suya100046834/a5d27_handheld_console/a5d27_handheld_console_pcb/3d/ER-TFTM043A2-3-4170_3D.STEP

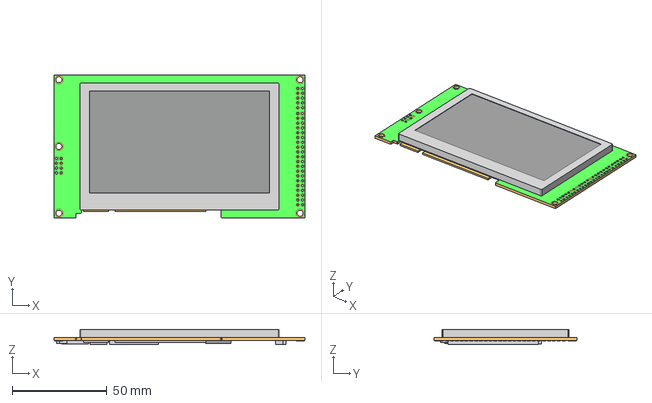
[picture p1: CAD file, 2024-01-07]
a5d27_handheld_console_pcb/3d/ER-TFTM043A2-3-4170_3D.STEP
132.7 x 75.8 x 7.90 mm
