suya100046834/a5d27_handheld_console/a5d27_handheld_console_pcb/a5d27_handheld_console_pcb.kicad_pcb

## KiCad design a5d27_handheld_console_pcb/a5d27_handheld_console_pcb.kicad_pcb (2024-01-07)

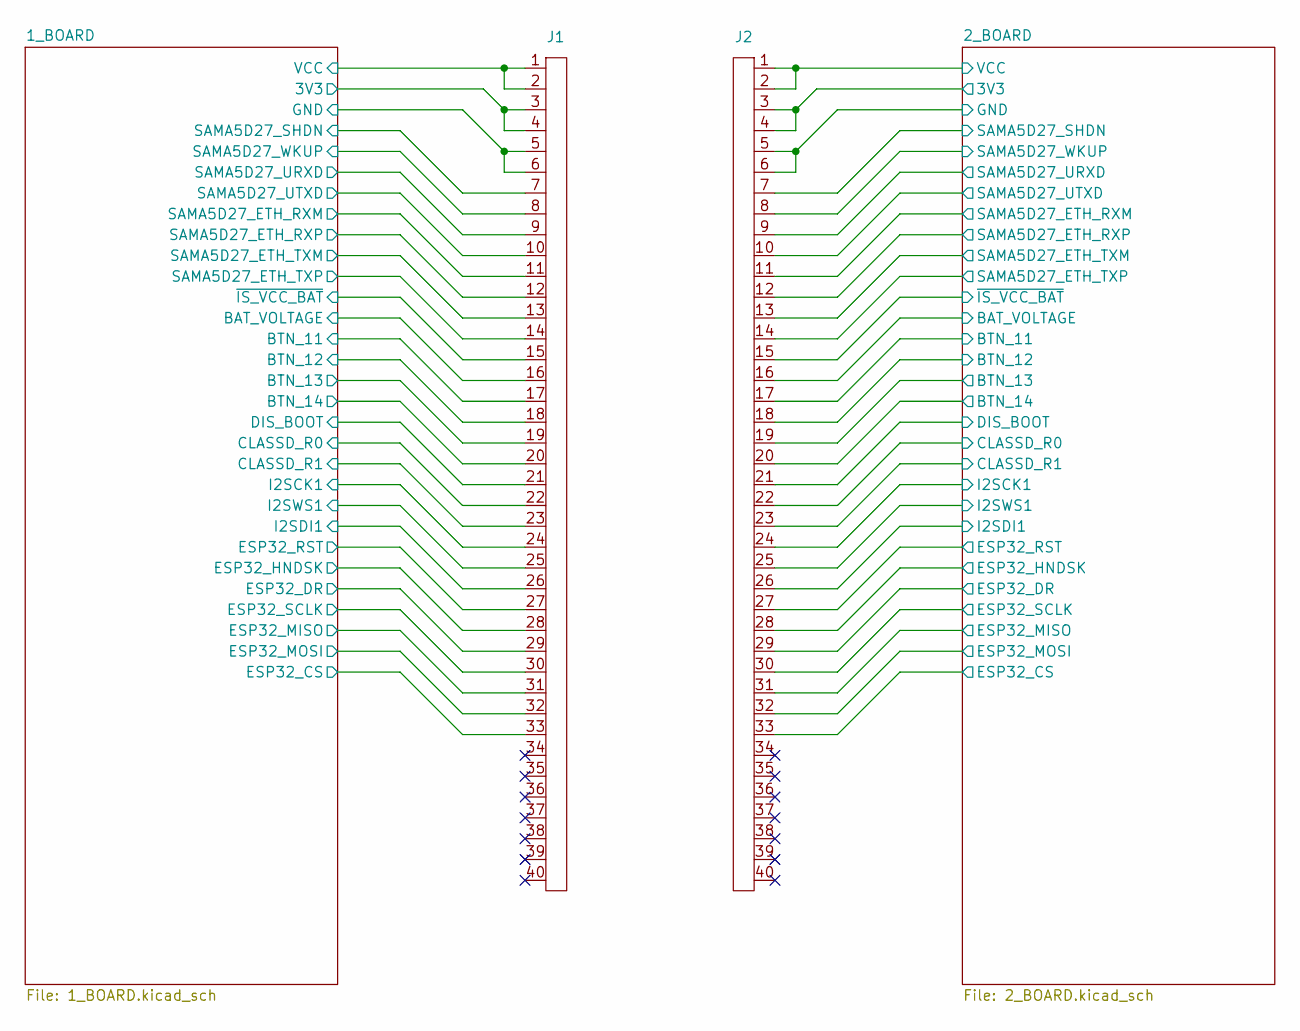
[picture p2: schematic a5d27_handheld_console_pcb.kicad_sch]

Parts:
J1: CONN_MALE
J2: CONN_FEMALE

Connections:
3V3_1: J1.3, J1.4; also elsewhere on the board
3V3_2: J2.3, J2.4; also elsewhere on the board
/1_BOARD/BAT_VOLTAGE: J1.16; also elsewhere on the board
/1_BOARD/BTN_11: J1.17; also elsewhere on the board
/1_BOARD/BTN_12: J1.18; also elsewhere on the board
/1_BOARD/BTN_13: J1.19; also elsewhere on the board
/1_BOARD/BTN_14: J1.20; also elsewhere on the board
/1_BOARD/CLASSD_R0: J1.22; also elsewhere on the board
/1_BOARD/CLASSD_R1: J1.23; also elsewhere on the board
/1_BOARD/DIS_BOOT: J1.21; also elsewhere on the board
/1_BOARD/ESP32_CS: J1.33; also elsewhere on the board
/1_BOARD/ESP32_DR: J1.29; also elsewhere on the board
/1_BOARD/ESP32_HNDSK: J1.28; also elsewhere on the board
/1_BOARD/ESP32_MISO: J1.31; also elsewhere on the board
/1_BOARD/ESP32_MOSI: J1.32; also elsewhere on the board
/1_BOARD/ESP32_RST: J1.27; also elsewhere on the board
/1_BOARD/ESP32_SCLK: J1.30; also elsewhere on the board
/1_BOARD/I2SCK1: J1.24; also elsewhere on the board
/1_BOARD/I2SDI1: J1.26; also elsewhere on the board
/1_BOARD/I2SWS1: J1.25; also elsewhere on the board
/1_BOARD/SAMA5D27_ETH_RXM: J1.11; also elsewhere on the board
/1_BOARD/SAMA5D27_ETH_RXP: J1.12; also elsewhere on the board
/1_BOARD/SAMA5D27_ETH_TXM: J1.13; also elsewhere on the board
/1_BOARD/SAMA5D27_ETH_TXP: J1.14; also elsewhere on the board
/1_BOARD/SAMA5D27_SHDN: J1.7; also elsewhere on the board
/1_BOARD/SAMA5D27_URXD: J1.9; also elsewhere on the board
/1_BOARD/SAMA5D27_UTXD: J1.10; also elsewhere on the board
/1_BOARD/SAMA5D27_WKUP: J1.8; also elsewhere on the board
/1_BOARD/~IS_VCC_BAT: J1.15; also elsewhere on the board
/2_BOARD/BAT_VOLTAGE: J2.16; also elsewhere on the board
/2_BOARD/BTN_11: J2.17; also elsewhere on the board
/2_BOARD/BTN_12: J2.18; also elsewhere on the board
/2_BOARD/BTN_13: J2.19; also elsewhere on the board
/2_BOARD/BTN_14: J2.20; also elsewhere on the board
/2_BOARD/CLASSD_R0: J2.22; also elsewhere on the board
/2_BOARD/CLASSD_R1: J2.23; also elsewhere on the board
/2_BOARD/DIS_BOOT: J2.21; also elsewhere on the board
/2_BOARD/ESP32_CS: J2.33; also elsewhere on the board
/2_BOARD/ESP32_DR: J2.29; also elsewhere on the board
/2_BOARD/ESP32_HNDSK: J2.28; also elsewhere on the board
/2_BOARD/ESP32_MISO: J2.31; also elsewhere on the board
/2_BOARD/ESP32_MOSI: J2.32; also elsewhere on the board
/2_BOARD/ESP32_RST: J2.27; also elsewhere on the board
/2_BOARD/ESP32_SCLK: J2.30; also elsewhere on the board
/2_BOARD/I2SCK1: J2.24; also elsewhere on the board
/2_BOARD/I2SDI1: J2.26; also elsewhere on the board
/2_BOARD/I2SWS1: J2.25; also elsewhere on the board
/2_BOARD/SAMA5D27_ETH_RXM: J2.11; also elsewhere on the board
/2_BOARD/SAMA5D27_ETH_RXP: J2.12; also elsewhere on the board
/2_BOARD/SAMA5D27_ETH_TXM: J2.13; also elsewhere on the board
/2_BOARD/SAMA5D27_ETH_TXP: J2.14; also elsewhere on the board
/2_BOARD/SAMA5D27_SHDN: J2.7; also elsewhere on the board
/2_BOARD/SAMA5D27_URXD: J2.9; also elsewhere on the board
/2_BOARD/SAMA5D27_UTXD: J2.10; also elsewhere on the board
/2_BOARD/SAMA5D27_WKUP: J2.8; also elsewhere on the board
/2_BOARD/~IS_VCC_BAT: J2.15; also elsewhere on the board
GND_1: J1.5, J1.6; also elsewhere on the board
GND_2: J2.5, J2.6; also elsewhere on the board
VCC_1: J1.1, J1.2; also elsewhere on the board
VCC_2: J2.1, J2.2; also elsewhere on the board

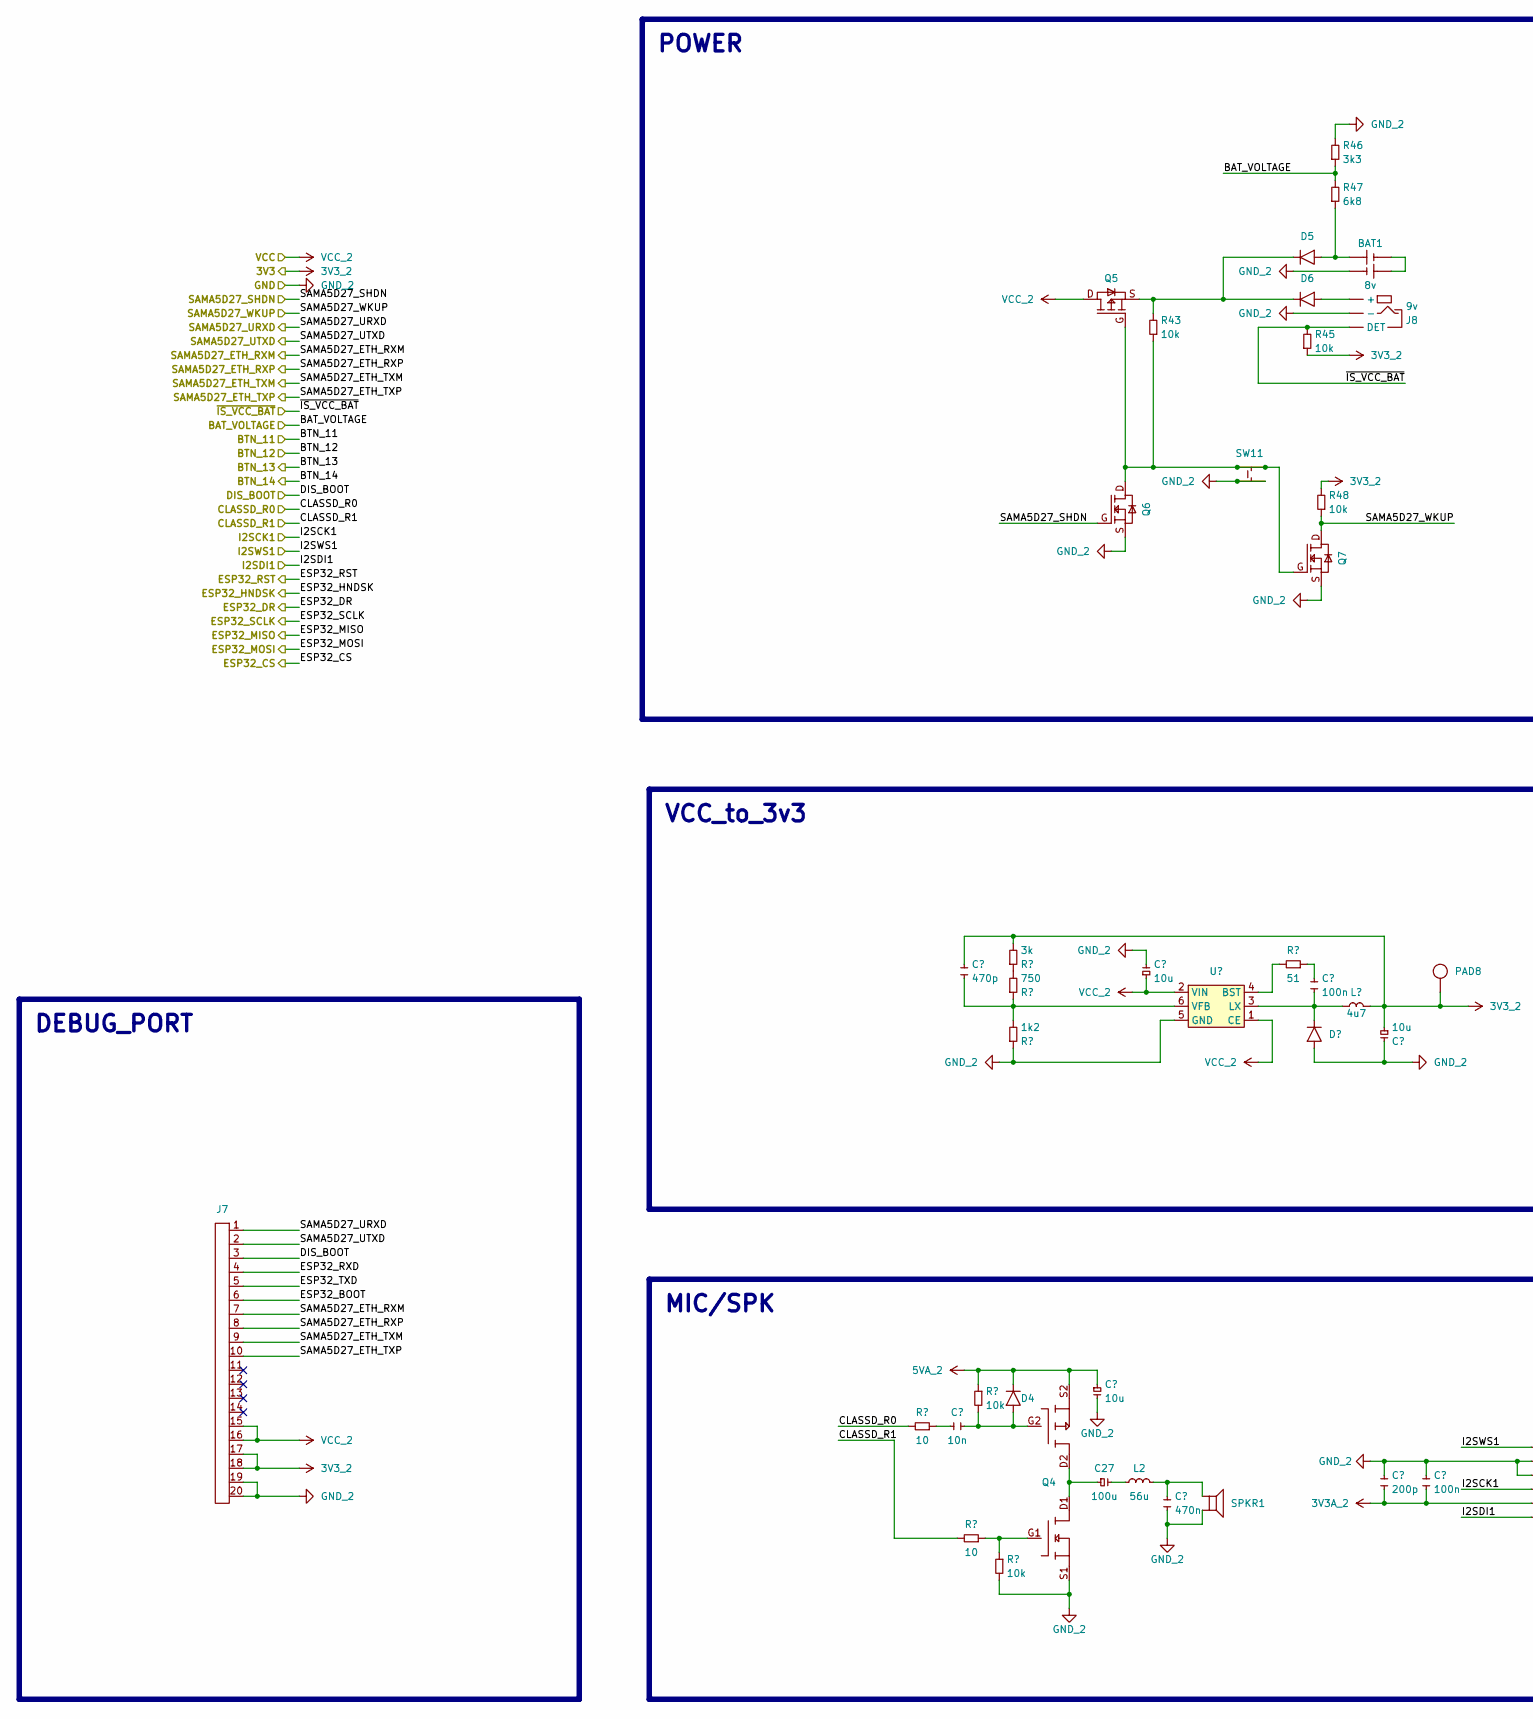
[picture p3: schematic 2_BOARD.kicad_sch, part in row 1, column 1]

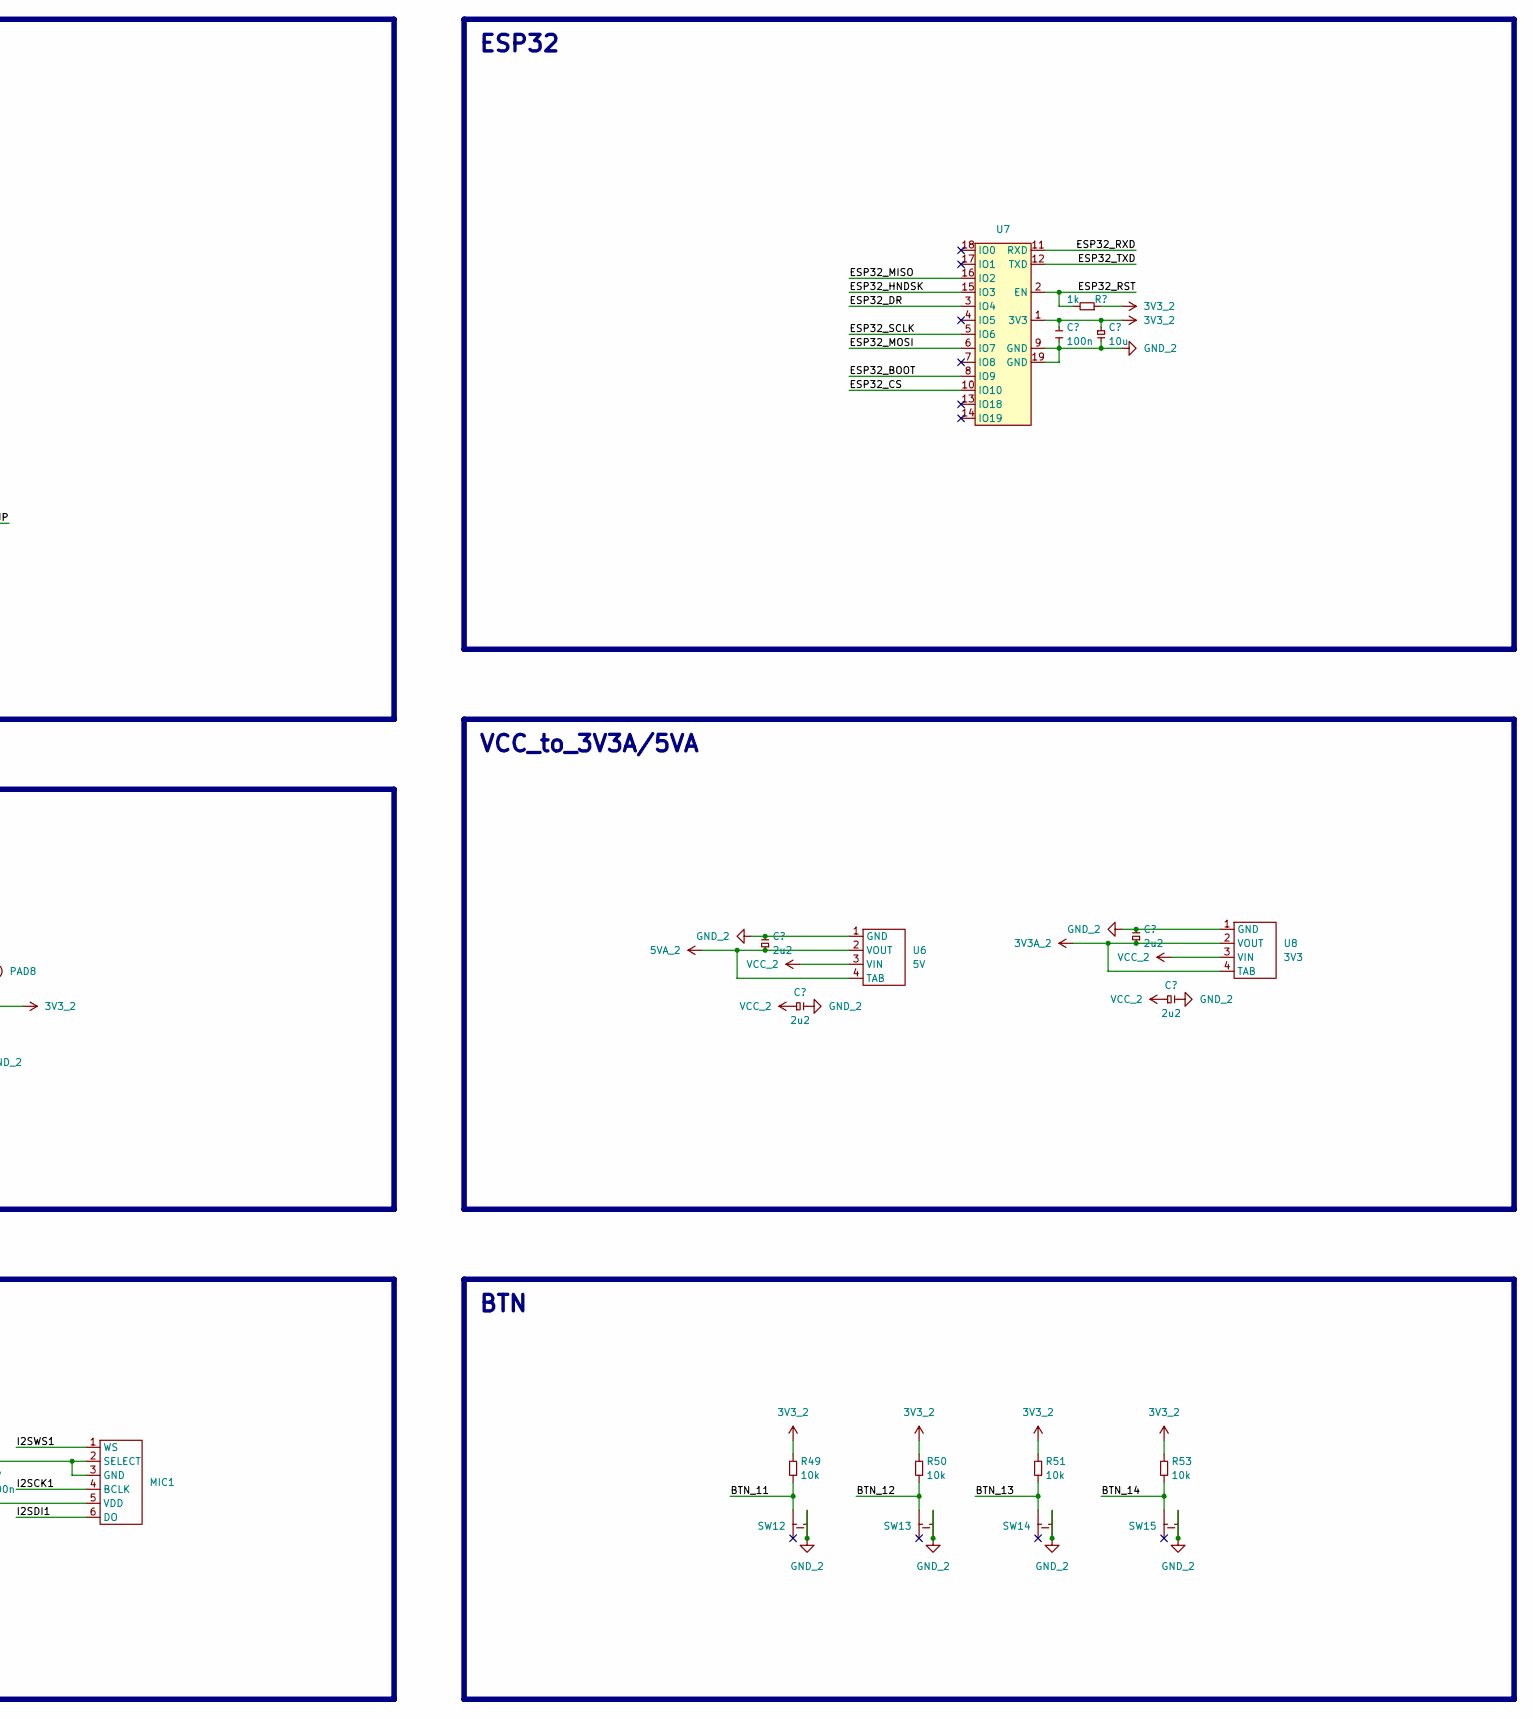
[picture p4: schematic 2_BOARD.kicad_sch, part in row 1, column 2]

Parts:
BAT1: 8v; BAT
C24: 10n; C_Ceramic_2012
C25: 470p; C_Ceramic_2012
C26, C28, C31, C37: 10u; C_Tantalum_3216
C27: 100u; CAP_6.3pix5.3mm
C29: 470n; C_Ceramic_2012
C30, C33, C36: 100n; C_Ceramic_2012
C32: 200p; C_Ceramic_2012
C34, C35, C38, C39: 2u2; C_Tantalum_3216
D4, D7: CMS06
D5, D6: ES2DA-13-F
J7: DEBUG_PORT
J8: 9v; DC_JACK
L2: 56u; LQH3NPH560MMEL
L3: 4u7; DFE252012F-4R7M
MIC1: SPH0645LM4H-B
PAD8: PAD
Q4: DMC2400UV
Q5: DMP3099L
Q6, Q7: N-FET
R36, R37: 10; R_2012
R38, R42, R43, R45, R48, R49, R50, R51, R53: 10k; R_2012
R39: 3k; R_2012
R40: 750; R_2012
R41: 1k2; R_2012
R44: 51; R_2012
R46: 3k3; R_2012
R47: 6k8; R_2012
R52: 1k; R_2012
SPKR1: SPEAKER
SW11, SW12, SW13, SW14, SW15: EVQ-P7A01P
U5: R1240N001B
U6: 5V; 1117
U7: ESP32-C3-WROOM-02
U8: 3V3; 1117

Connections:
3V3A_2: C32.2, C33.2, C38.1, MIC1.5 (VDD), U8.2 (VOUT), U8.4 (TAB)
3V3_2: C25.2, C31.1, C36.2, C37.1, J7.17, J7.18, L3.2, PAD8.1, R39.2, R45.1, R48.2, R49.2, R50.2, R51.2, R52.1, R53.2, U7.1 (3V3); also elsewhere on the board
5VA_2: C26.1, C34.1, D4.2, Q4.S2, R38.1, U6.2 (VOUT), U6.4 (TAB)
/2_BOARD/BAT_VOLTAGE: R46.1, R47.2; also elsewhere on the board
/2_BOARD/BTN_11: R49.1, SW12.3; also elsewhere on the board
/2_BOARD/BTN_12: R50.1, SW13.3; also elsewhere on the board
/2_BOARD/BTN_13: R51.1, SW14.3; also elsewhere on the board
/2_BOARD/BTN_14: R53.1, SW15.3; also elsewhere on the board
/2_BOARD/CLASSD_R0: R36.2; also elsewhere on the board
/2_BOARD/CLASSD_R1: R37.2; also elsewhere on the board
/2_BOARD/DIS_BOOT: J7.3; also elsewhere on the board
/2_BOARD/ESP32_BOOT: J7.6, U7.8 (IO9)
/2_BOARD/ESP32_CS: U7.10 (IO10); also elsewhere on the board
/2_BOARD/ESP32_DR: U7.3 (IO4); also elsewhere on the board
/2_BOARD/ESP32_HNDSK: U7.15 (IO3); also elsewhere on the board
/2_BOARD/ESP32_MISO: U7.16 (IO2); also elsewhere on the board
/2_BOARD/ESP32_MOSI: U7.6 (IO7); also elsewhere on the board
/2_BOARD/ESP32_RST: R52.2, U7.2 (EN); also elsewhere on the board
/2_BOARD/ESP32_RXD: J7.4, U7.11 (RXD)
/2_BOARD/ESP32_SCLK: U7.5 (IO6); also elsewhere on the board
/2_BOARD/ESP32_TXD: J7.5, U7.12 (TXD)
/2_BOARD/I2SCK1: MIC1.4 (BCLK); also elsewhere on the board
/2_BOARD/I2SDI1: MIC1.6 (DO); also elsewhere on the board
/2_BOARD/I2SWS1: MIC1.1 (WS); also elsewhere on the board
/2_BOARD/SAMA5D27_ETH_RXM: J7.7; also elsewhere on the board
/2_BOARD/SAMA5D27_ETH_RXP: J7.8; also elsewhere on the board
/2_BOARD/SAMA5D27_ETH_TXM: J7.9; also elsewhere on the board
/2_BOARD/SAMA5D27_ETH_TXP: J7.10; also elsewhere on the board
/2_BOARD/SAMA5D27_SHDN: Q6.G; also elsewhere on the board
/2_BOARD/SAMA5D27_URXD: J7.1; also elsewhere on the board
/2_BOARD/SAMA5D27_UTXD: J7.2; also elsewhere on the board
/2_BOARD/SAMA5D27_WKUP: Q7.D, R48.1; also elsewhere on the board
/2_BOARD/~IS_VCC_BAT: J8.3 (DET), R45.2; also elsewhere on the board
GND_2: BAT1.3, C26.2, C28.2, C29.2, C31.2, C32.1, C33.1, C34.2, C35.2, C36.1, C37.2, C38.2, C39.2, D7.1, J7.19, J7.20, J8.2 (-), MIC1.2 (SELECT), MIC1.3 (GND), Q4.S1, Q6.S, Q7.S, R41.1, R42.2, R46.2, SPKR1.2, SW11.1, SW11.2, SW12.1, SW12.2, SW13.1, SW13.2, SW14.1, SW14.2, SW15.1, SW15.2, U5.5 (GND), U6.1 (GND), U7.9 (GND), U7.19 (GND), U8.1 (GND); also elsewhere on the board
unnamed: BAT1.1, D5.1, R47.1
unnamed: BAT1.2, BAT1.4
unnamed: C24.1, D4.1, Q4.G2, R38.2
unnamed: C24.2, R36.1
unnamed: C27.1, Q4.D1, Q4.D2
unnamed: C27.2, L2.1
unnamed: C29.1, L2.2, SPKR1.1
unnamed: C30.2, R44.1
unnamed: D5.2, D6.2, Q5.S, R43.2
unnamed: D6.1, J8.1 (+)
unnamed: Q4.G1, R37.1, R42.1
unnamed: Q5.G, Q6.D, Q7.G, R43.1, SW11.3, SW11.4
unnamed: R39.1, R40.2
unnamed: R44.2, U5.4 (BST)
unnamed: C30.1, D7.2, L3.1, U5.3 (LX)
unnamed: C25.1, R40.1, R41.2, U5.6 (VFB)
VCC_2: C28.1, C35.1, C39.1, J7.15, J7.16, Q5.D, U5.1 (CE), U5.2 (VIN), U6.3 (VIN), U8.3 (VIN); also elsewhere on the board

Notes on the sheet:
MIC/SPK
POWER
DEBUG_PORT
ESP32
BTN
VCC_to_3V3A/5VA
VCC_to_3v3

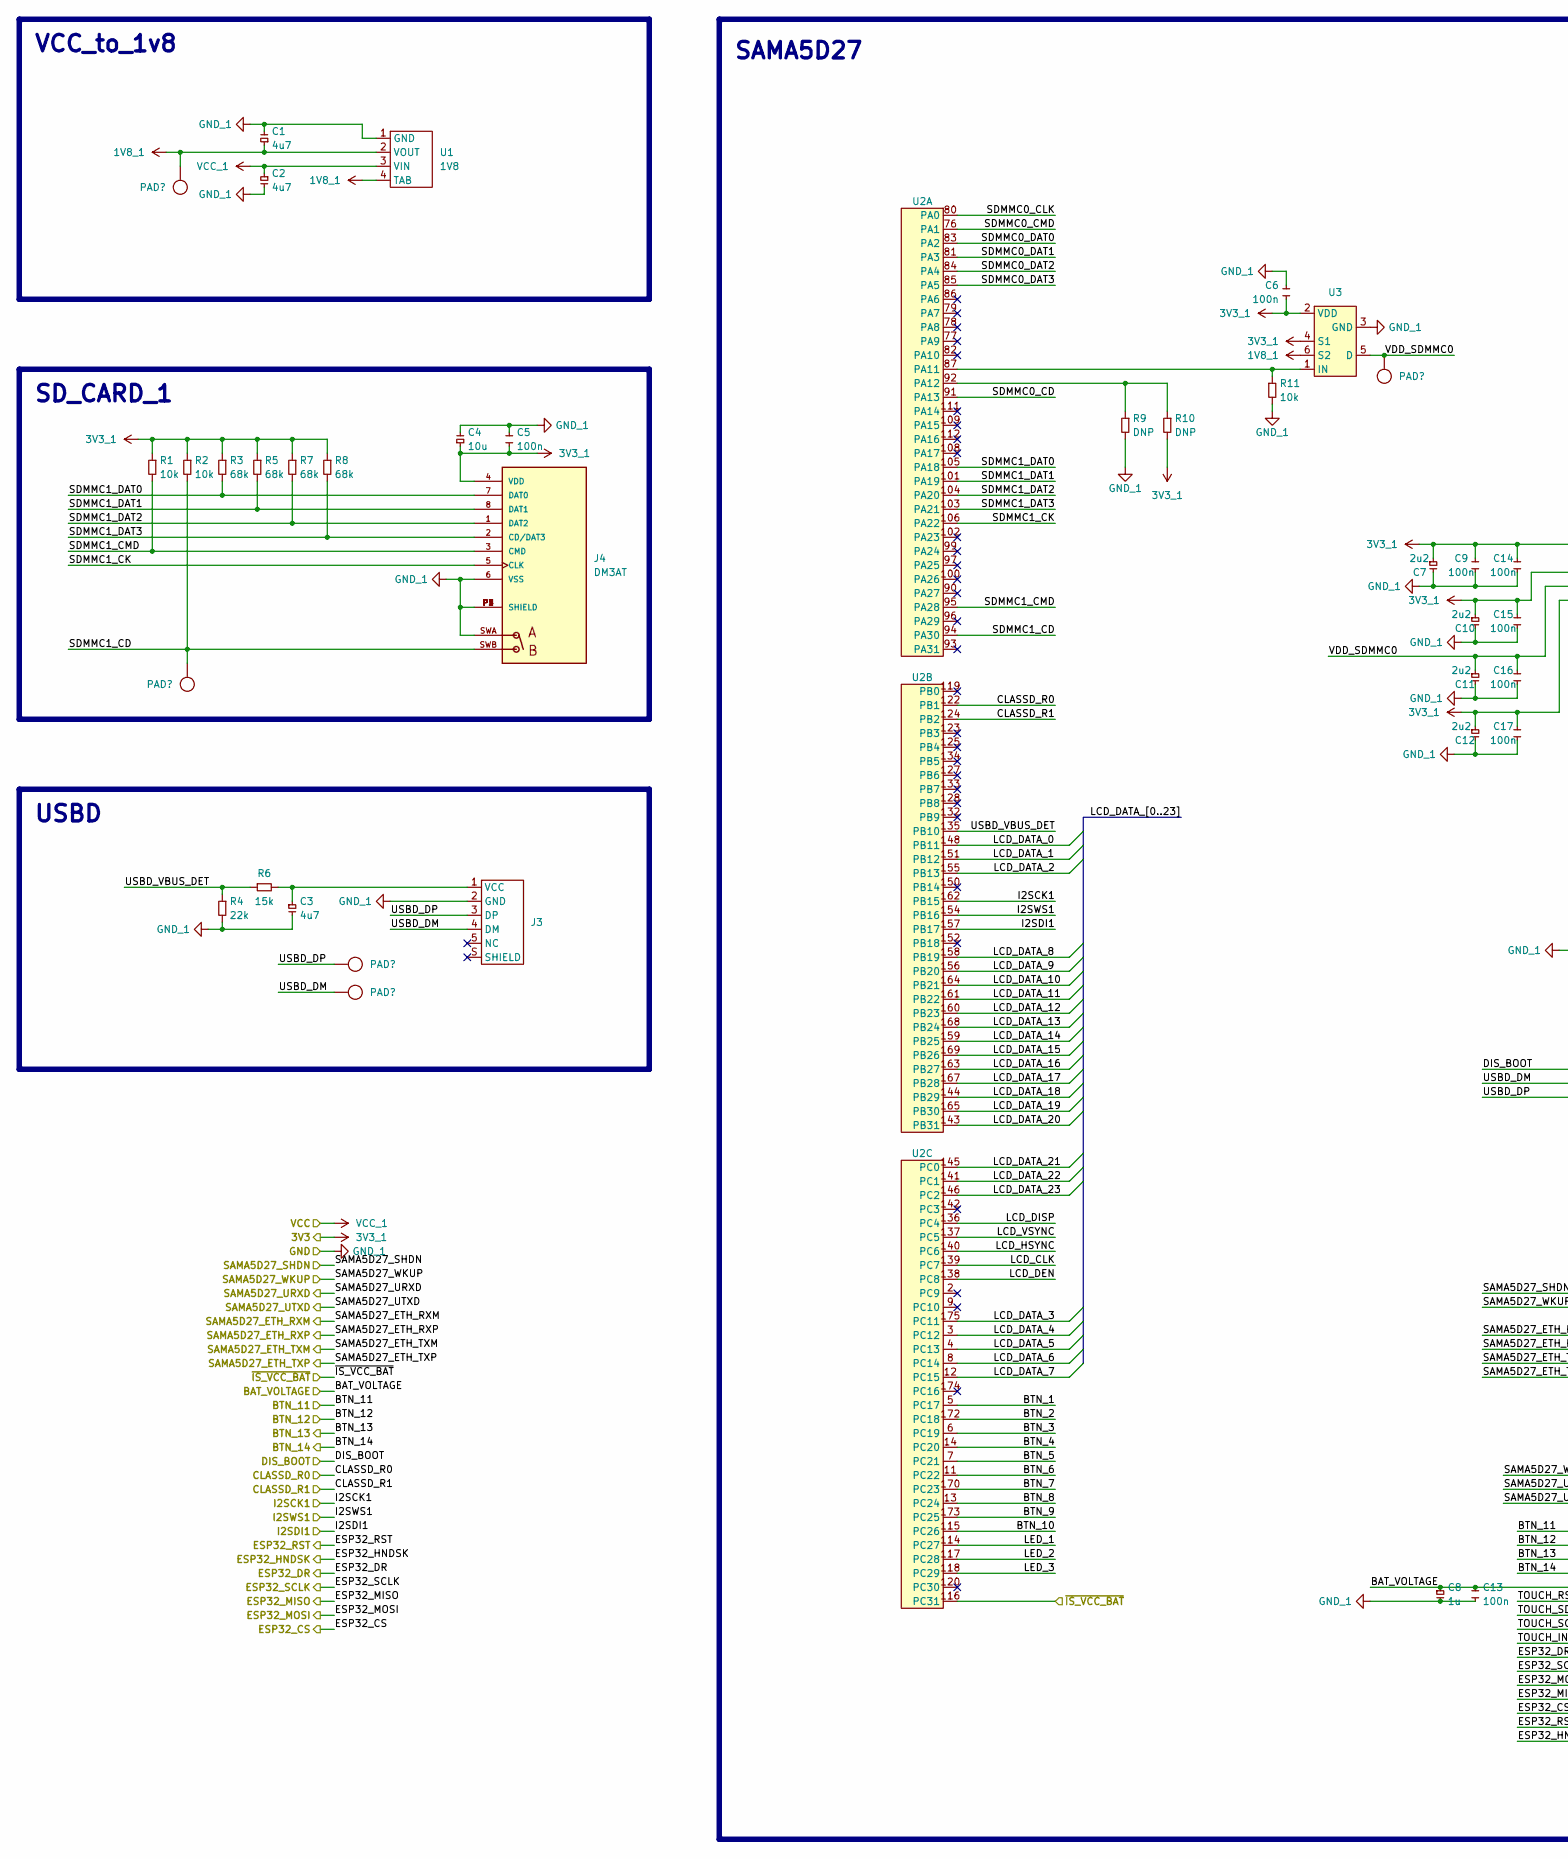
[picture p5: schematic 1_BOARD.kicad_sch, part in row 1, column 1]

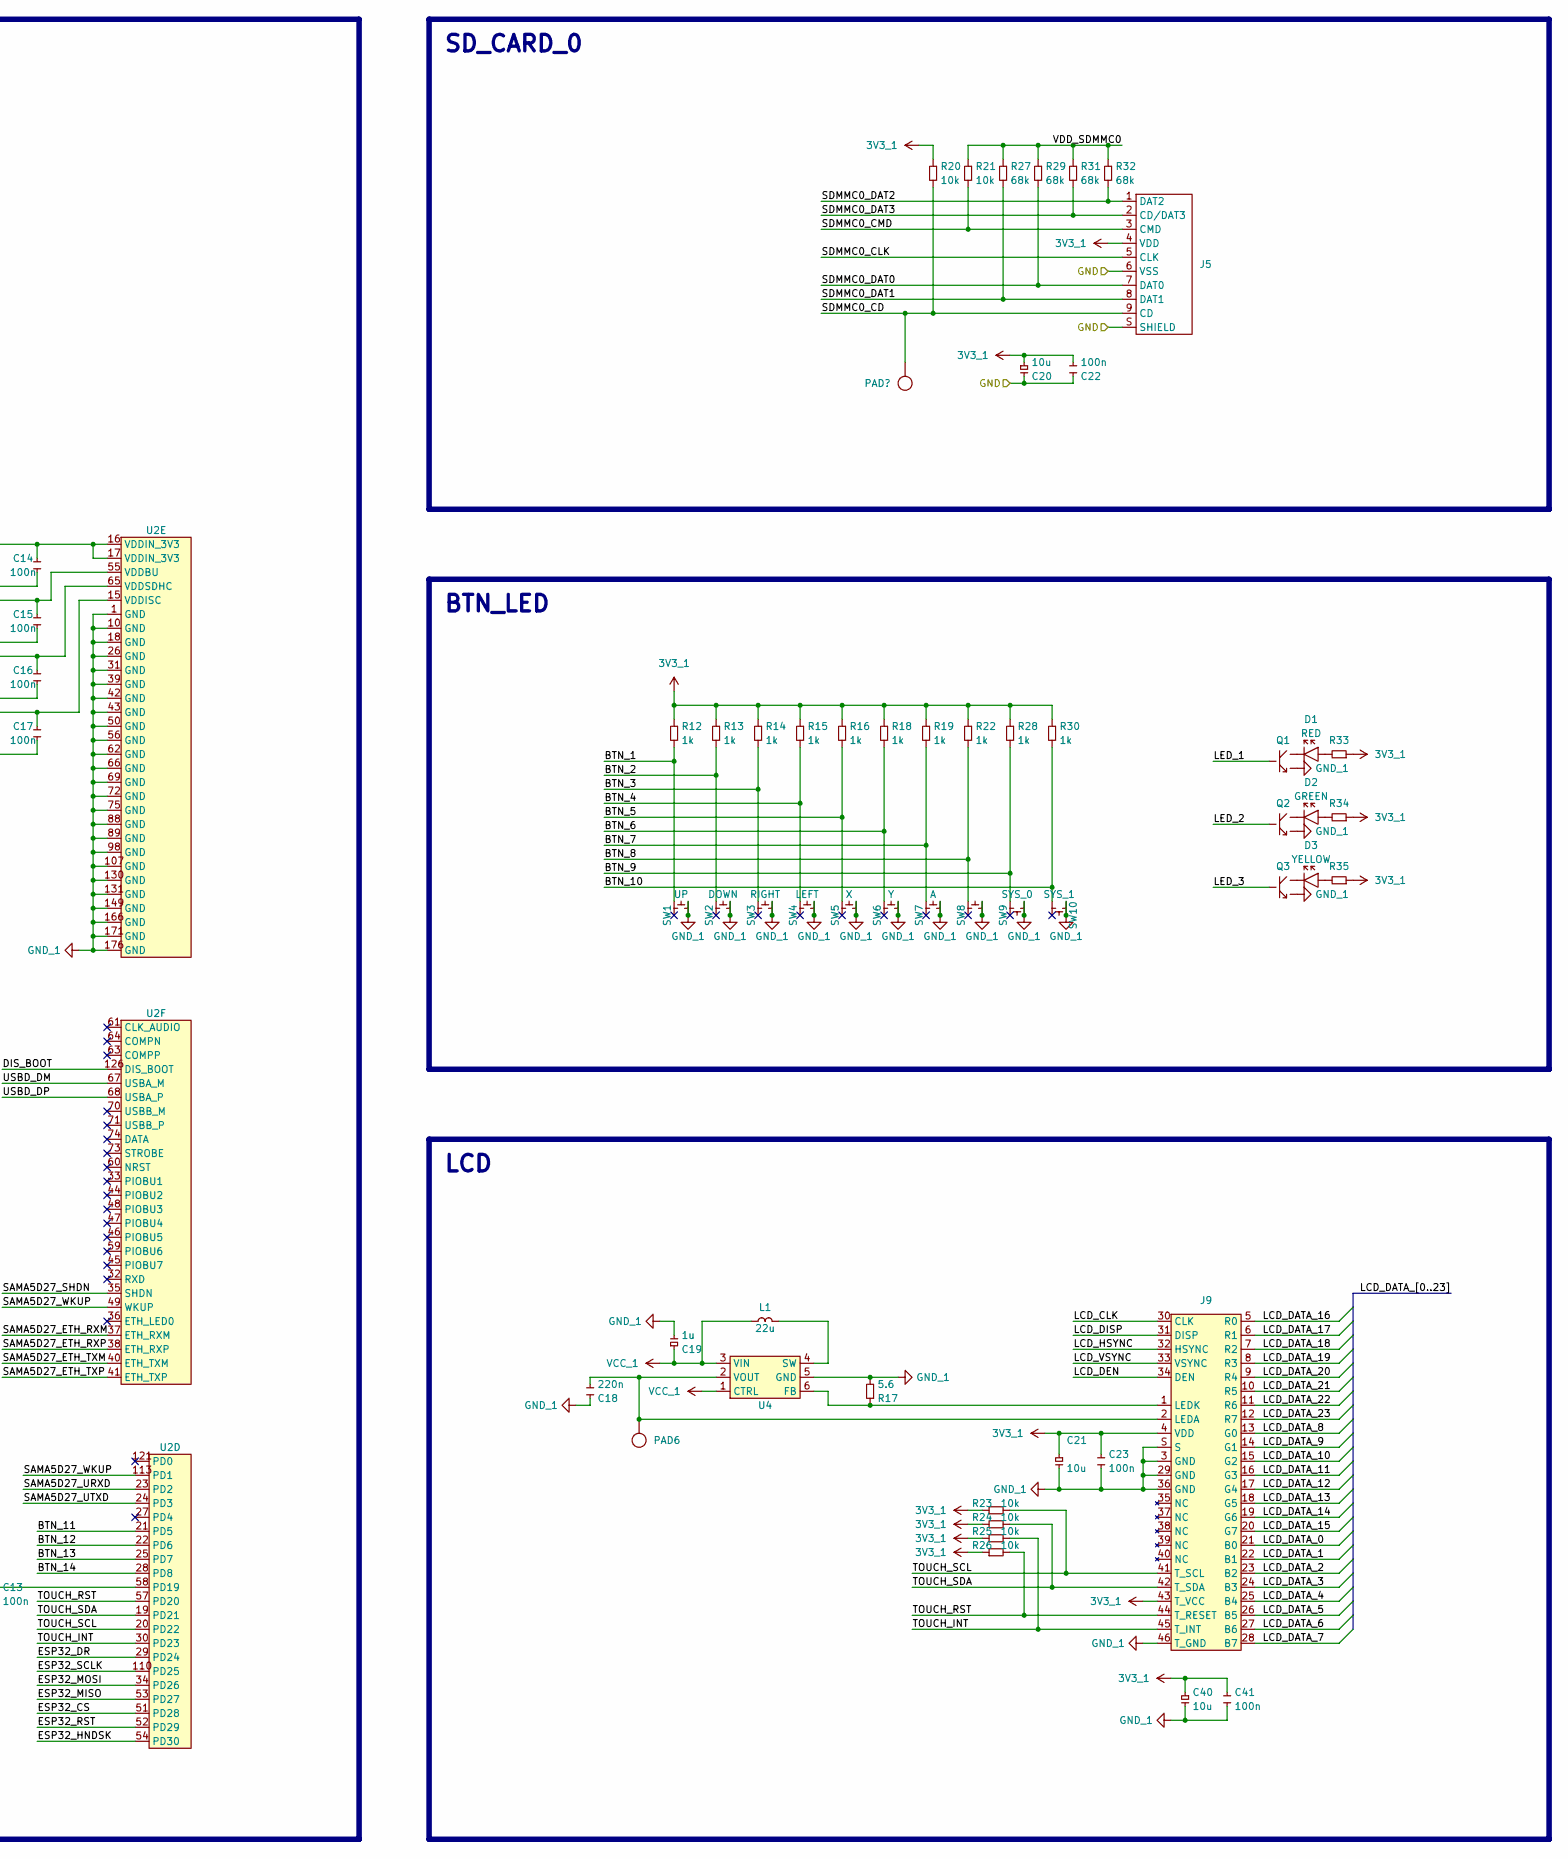
[picture p6: schematic 1_BOARD.kicad_sch, part in row 1, column 2]

Parts:
C1, C2, C3: 4u7; C_Tantalum_3216
C4, C20, C21, C40: 10u; C_Tantalum_3216
C5, C6, C9, C13, C14, C15, C16, C17, C22, C23, C41: 100n; C_Ceramic_2012
C7, C10, C11, C12: 2u2; C_Tantalum_3216
C8, C19: 1u; C_Tantalum_3216
C18: 220n; C_Ceramic_2012
D1: RED; LED_2012
D2: GREEN; LED_2012
D3: YELLOW; LED_2012
J3: USB_B
J4: DM3AT; HRS_DM3AT-SF-PEJM5
J5: DM3CS
J9: ER-TFT043-7
L1: 22u; NLCV25T-220K-PF
PAD1, PAD2, PAD3, PAD4, PAD5, PAD6, PAD7: PAD
Q1, Q2, Q3: MMBT3904
R1, R2, R11, R20, R21, R23, R24, R25, R26: 10k; R_2012
R3, R5, R7, R8, R27, R29, R31, R32: 68k; R_2012
R4: 22k; R_2012
R6: 15k; R_2012
R9, R10: DNP; R_2012
R12, R13, R14, R15, R16, R18, R19, R22, R28, R30: 1k; R_2012
R17: 5.6; R_2012
R33, R34, R35: R_2012
SW1: UP; SWITCH
SW2: DOWN; SWITCH
SW3: RIGHT; SWITCH
SW4: LEFT; SWITCH
SW5: X; SWITCH
SW6: Y; SWITCH
SW7: A; SWITCH
SW8: B; SWITCH
SW9: SYS_0; SWITCH
SW10: SYS_1; SWITCH
U1: 1V8; 1117
U2: ATSAMA5D27-SOM1
U3: ADG849
U4: AP3036B

Connections:
1V8_1: C1.1, PAD1.1, U1.2 (VOUT), U1.4 (TAB), U3.6 (S2)
3V3_1: C4.1, C5.2, C6.1, C7.1, C9.2, C10.1, C12.1, C14.2, C15.2, C17.2, C20.1, C21.1, C22.2, C23.2, C40.1, C41.2, J4.4 (VDD), J5.4 (VDD), J9.4 (VDD), J9.43 (T_VCC), R1.1, R2.1, R3.1, R5.1, R7.1, R8.1, R10.2, R12.1, R13.1, R14.1, R15.1, R16.1, R18.1, R19.1, R20.1, R22.1, R23.1, R24.1, R25.1, R26.1, R28.1, R30.1, R33.1, R34.1, R35.1, U2.15 (VDDISC), U2.16 (VDDIN_3V3), U2.17 (VDDIN_3V3), U2.55 (VDDBU), U3.2 (VDD), U3.4 (S1); also elsewhere on the board
/1_BOARD/BAT_VOLTAGE: C8.1, C13.2, U2.58 (PD19); also elsewhere on the board
/1_BOARD/BTN_1: R12.2, SW1.2, U2.5 (PC17); also elsewhere on the board
/1_BOARD/BTN_2: R13.2, SW2.2, U2.172 (PC18); also elsewhere on the board
/1_BOARD/BTN_3: R14.2, SW3.2, U2.6 (PC19); also elsewhere on the board
/1_BOARD/BTN_4: R15.2, SW4.2, U2.14 (PC20); also elsewhere on the board
/1_BOARD/BTN_5: R16.2, SW5.2, U2.7 (PC21); also elsewhere on the board
/1_BOARD/BTN_6: R18.2, SW6.2, U2.11 (PC22); also elsewhere on the board
/1_BOARD/BTN_7: R19.2, SW7.2, U2.170 (PC23); also elsewhere on the board
/1_BOARD/BTN_8: R22.2, SW8.2, U2.13 (PC24); also elsewhere on the board
/1_BOARD/BTN_9: R28.2, SW9.1, U2.173 (PC25)
/1_BOARD/BTN_10: R30.2, SW10.3, U2.115 (PC26)
/1_BOARD/BTN_11: U2.21 (PD5); also elsewhere on the board
/1_BOARD/BTN_12: U2.22 (PD6); also elsewhere on the board
/1_BOARD/BTN_13: U2.25 (PD7); also elsewhere on the board
/1_BOARD/BTN_14: U2.28 (PD8); also elsewhere on the board
/1_BOARD/CLASSD_R0: U2.122 (PB1); also elsewhere on the board
/1_BOARD/CLASSD_R1: U2.124 (PB2); also elsewhere on the board
/1_BOARD/DIS_BOOT: U2.126 (DIS_BOOT); also elsewhere on the board
/1_BOARD/ESP32_CS: U2.51 (PD28); also elsewhere on the board
/1_BOARD/ESP32_DR: U2.29 (PD24); also elsewhere on the board
/1_BOARD/ESP32_HNDSK: U2.54 (PD30); also elsewhere on the board
/1_BOARD/ESP32_MISO: U2.53 (PD27); also elsewhere on the board
/1_BOARD/ESP32_MOSI: U2.34 (PD26); also elsewhere on the board
/1_BOARD/ESP32_RST: U2.52 (PD29); also elsewhere on the board
/1_BOARD/ESP32_SCLK: U2.110 (PD25); also elsewhere on the board
/1_BOARD/I2SCK1: U2.162 (PB15); also elsewhere on the board
/1_BOARD/I2SDI1: U2.157 (PB17); also elsewhere on the board
/1_BOARD/I2SWS1: U2.154 (PB16); also elsewhere on the board
/1_BOARD/LCD_CLK: J9.30 (CLK), U2.139 (PC7)
/1_BOARD/LCD_DATA_0: J9.21 (B0), U2.148 (PB11)
/1_BOARD/LCD_DATA_1: J9.22 (B1), U2.151 (PB12)
/1_BOARD/LCD_DATA_2: J9.23 (B2), U2.155 (PB13)
/1_BOARD/LCD_DATA_3: J9.24 (B3), U2.175 (PC11)
/1_BOARD/LCD_DATA_4: J9.25 (B4), U2.3 (PC12)
/1_BOARD/LCD_DATA_5: J9.26 (B5), U2.4 (PC13)
/1_BOARD/LCD_DATA_6: J9.27 (B6), U2.8 (PC14)
/1_BOARD/LCD_DATA_7: J9.28 (B7), U2.12 (PC15)
/1_BOARD/LCD_DATA_8: J9.13 (G0), U2.158 (PB19)
/1_BOARD/LCD_DATA_9: J9.14 (G1), U2.156 (PB20)
/1_BOARD/LCD_DATA_10: J9.15 (G2), U2.164 (PB21)
/1_BOARD/LCD_DATA_11: J9.16 (G3), U2.161 (PB22)
/1_BOARD/LCD_DATA_12: J9.17 (G4), U2.160 (PB23)
/1_BOARD/LCD_DATA_13: J9.18 (G5), U2.168 (PB24)
/1_BOARD/LCD_DATA_14: J9.19 (G6), U2.159 (PB25)
/1_BOARD/LCD_DATA_15: J9.20 (G7), U2.169 (PB26)
/1_BOARD/LCD_DATA_16: J9.5 (R0), U2.163 (PB27)
/1_BOARD/LCD_DATA_17: J9.6 (R1), U2.167 (PB28)
/1_BOARD/LCD_DATA_18: J9.7 (R2), U2.144 (PB29)
/1_BOARD/LCD_DATA_19: J9.8 (R3), U2.165 (PB30)
/1_BOARD/LCD_DATA_20: J9.9 (R4), U2.143 (PB31)
/1_BOARD/LCD_DATA_21: J9.10 (R5), U2.145 (PC0)
/1_BOARD/LCD_DATA_22: J9.11 (R6), U2.141 (PC1)
/1_BOARD/LCD_DATA_23: J9.12 (R7), U2.146 (PC2)
/1_BOARD/LCD_DEN: J9.34 (DEN), U2.138 (PC8)
/1_BOARD/LCD_DISP: J9.31 (DISP), U2.136 (PC4)
/1_BOARD/LCD_HSYNC: J9.32 (HSYNC), U2.140 (PC6)
/1_BOARD/LCD_VSYNC: J9.33 (VSYNC), U2.137 (PC5)
/1_BOARD/LED_1: Q1.1 (B), U2.114 (PC27)
/1_BOARD/LED_2: Q2.1 (B), U2.117 (PC28)
/1_BOARD/LED_3: Q3.1 (B), U2.118 (PC29)
/1_BOARD/SAMA5D27_ETH_RXM: U2.37 (ETH_RXM); also elsewhere on the board
/1_BOARD/SAMA5D27_ETH_RXP: U2.38 (ETH_RXP); also elsewhere on the board
/1_BOARD/SAMA5D27_ETH_TXM: U2.40 (ETH_TXM); also elsewhere on the board
/1_BOARD/SAMA5D27_ETH_TXP: U2.41 (ETH_TXP); also elsewhere on the board
/1_BOARD/SAMA5D27_SHDN: U2.35 (SHDN); also elsewhere on the board
/1_BOARD/SAMA5D27_URXD: U2.23 (PD2); also elsewhere on the board
/1_BOARD/SAMA5D27_UTXD: U2.24 (PD3); also elsewhere on the board
/1_BOARD/SAMA5D27_WKUP: U2.49 (WKUP), U2.113 (PD1); also elsewhere on the board
/1_BOARD/SDMMC0_CD: J5.9 (CD), PAD7.1, R20.2, U2.91 (PA13)
/1_BOARD/SDMMC0_CLK: J5.5 (CLK), U2.80 (PA0)
/1_BOARD/SDMMC0_CMD: J5.3 (CMD), R21.2, U2.76 (PA1)
/1_BOARD/SDMMC0_DAT0: J5.7 (DAT0), R29.2, U2.83 (PA2)
/1_BOARD/SDMMC0_DAT1: J5.8 (DAT1), R27.2, U2.81 (PA3)
/1_BOARD/SDMMC0_DAT2: J5.1 (DAT2), R32.2, U2.84 (PA4)
/1_BOARD/SDMMC0_DAT3: J5.2 (CD/DAT3), R31.2, U2.85 (PA5)
/1_BOARD/SDMMC1_CD: J4.SWB, PAD2.1, R2.2, U2.94 (PA30)
/1_BOARD/SDMMC1_CK: J4.5 (CLK), U2.106 (PA22)
/1_BOARD/SDMMC1_CMD: J4.3 (CMD), R1.2, U2.95 (PA28)
/1_BOARD/SDMMC1_DAT0: J4.7 (DAT0), R3.2, U2.105 (PA18)
/1_BOARD/SDMMC1_DAT1: J4.8 (DAT1), R5.2, U2.101 (PA19)
/1_BOARD/SDMMC1_DAT2: J4.1 (DAT2), R7.2, U2.104 (PA20)
/1_BOARD/SDMMC1_DAT3: J4.2 (CD/DAT3), R8.2, U2.103 (PA21)
/1_BOARD/TOUCH_INT: J9.45 (T_INT), R25.2, U2.30 (PD23)
/1_BOARD/TOUCH_RST: J9.44 (T_RESET), R26.2, U2.57 (PD20)
/1_BOARD/TOUCH_SCL: J9.41 (T_SCL), R23.2, U2.20 (PD22)
/1_BOARD/TOUCH_SDA: J9.42 (T_SDA), R24.2, U2.19 (PD21)
/1_BOARD/USBD_DM: J3.4 (DM), PAD4.1, U2.67 (USBA_M)
/1_BOARD/USBD_DP: J3.3 (DP), PAD3.1, U2.68 (USBA_P)
/1_BOARD/USBD_VBUS_DET: R4.1, R6.1, U2.135 (PB10)
/1_BOARD/VDD_SDMMC0: C11.1, C16.2, PAD5.1, R21.1, R27.1, R29.1, R31.1, R32.1, U2.65 (VDDSDHC), U3.5 (D)
/1_BOARD/~IS_VCC_BAT: U2.116 (PC31); also elsewhere on the board
GND_1: C1.2, C2.2, C3.2, C4.2, C5.1, C6.2, C7.2, C8.2, C9.1, C10.2, C11.2, C12.2, C13.1, C14.1, C15.1, C16.1, C17.1, C18.2, C19.2, C20.2, C21.2, C22.1, C23.1, C40.2, C41.1, J3.2 (GND), J4.6 (VSS), J4.P1 (SHIELD), J4.P2 (SHIELD), J4.P3 (SHIELD), J4.P4 (SHIELD), J4.SWA, J5.6 (VSS), J5.S (SHIELD), J9.3 (GND), J9.29 (GND), J9.36 (GND), J9.46 (T_GND), J9.S, Q1.2 (E), Q2.2 (E), Q3.2 (E), R4.2, R9.2, R11.2, R17.2, SW1.3, SW1.4, SW2.3, SW2.4, SW3.3, SW3.4, SW4.3, SW4.4, SW5.3, SW5.4, SW6.3, SW6.4, SW7.3, SW7.4, SW8.3, SW8.4, SW9.3, SW9.4, SW10.1, SW10.2, U1.1 (GND), U2.1 (GND), U2.10 (GND), U2.18 (GND), U2.26 (GND), U2.31 (GND), U2.39 (GND), U2.42 (GND), U2.43 (GND), U2.50 (GND), U2.56 (GND), U2.62 (GND), U2.66 (GND), U2.69 (GND), U2.72 (GND), U2.75 (GND), U2.88 (GND), U2.89 (GND), U2.98 (GND), U2.107 (GND), U2.130 (GND), U2.131 (GND), U2.149 (GND), U2.166 (GND), U2.171 (GND), U2.176 (GND), U3.3 (GND), U4.5 (GND); also elsewhere on the board
unnamed: D1.1, R33.2
unnamed: D2.1, R34.2
unnamed: D3.1, R35.2
unnamed: C3.1, J3.1 (VCC), R6.2
unnamed: C18.1, J9.2 (LEDA), PAD6.1, U4.2 (VOUT)
unnamed: J9.1 (LEDK), R17.1, U4.6 (FB)
unnamed: D1.2, Q1.3 (C)
unnamed: D2.2, Q2.3 (C)
unnamed: D3.2, Q3.3 (C)
unnamed: R11.1, U2.87 (PA11), U3.1 (IN)
unnamed: R9.1, R10.1, U2.92 (PA12)
unnamed: L1.2, U4.4 (SW)
VCC_1: C2.1, C19.1, L1.1, U1.3 (VIN), U4.1 (CTRL), U4.3 (VIN); also elsewhere on the board

Notes on the sheet:
LCD
BTN_LED
USBD
SD_CARD_0
VCC_to_1v8
SD_CARD_1
SAMA5D27
