suya100046834/a5d27_handheld_console/a5d27_handheld_console_pcb/a5d27_handheld_console_pcb.kicad_pcb

## KiCad design a5d27_handheld_console_pcb/a5d27_handheld_console_pcb.kicad_pcb (continued)

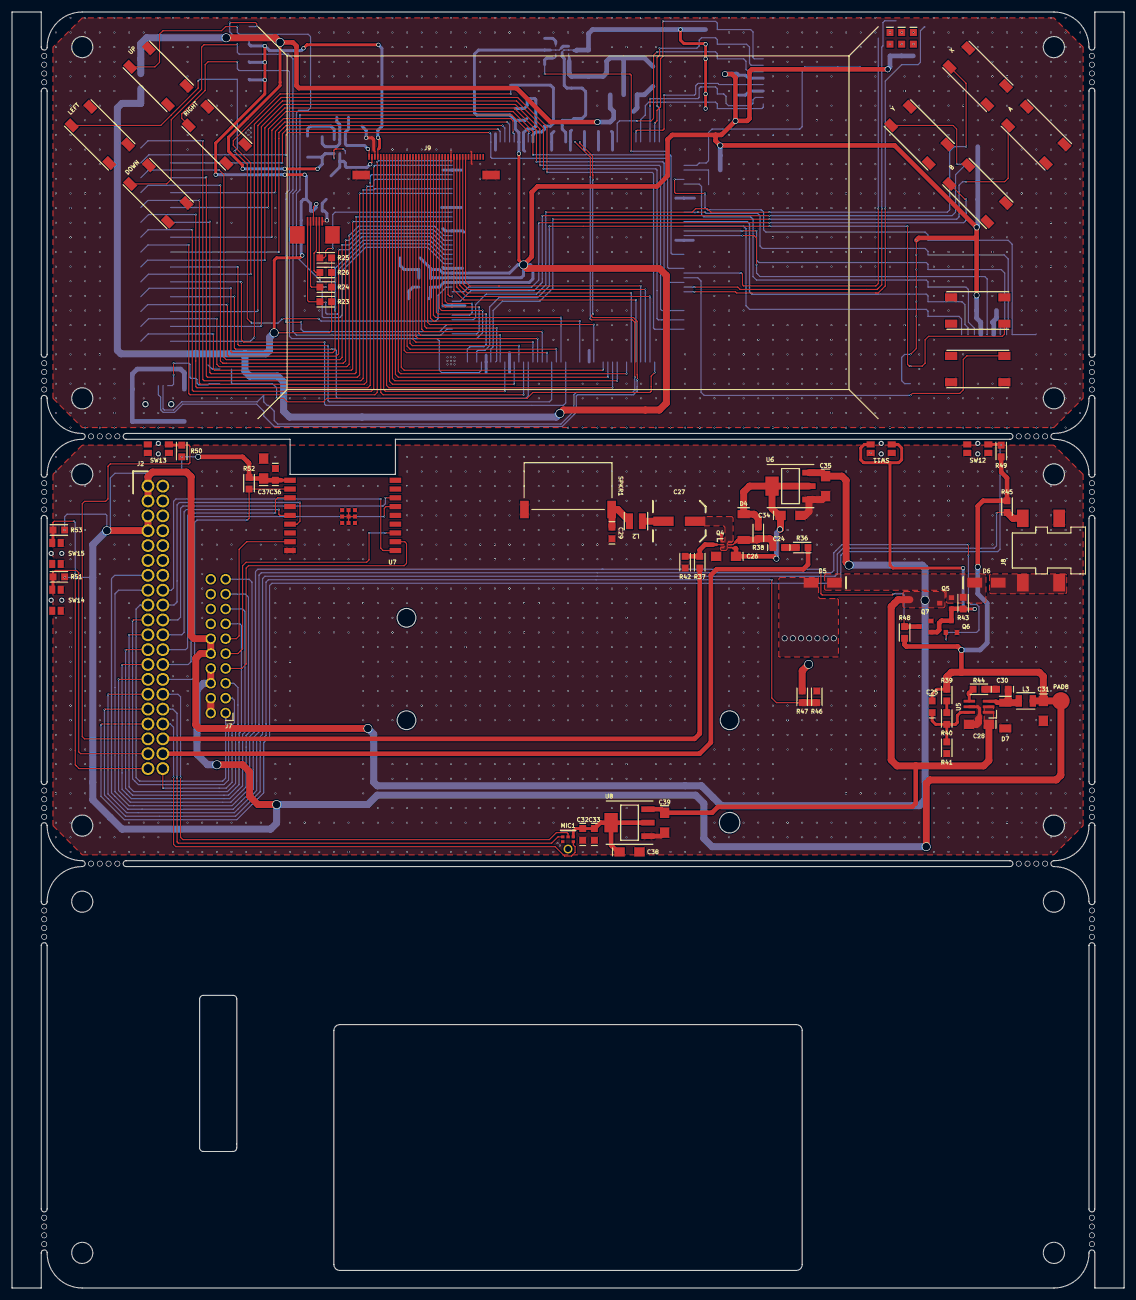
[picture p7: board a5d27_handheld_console_pcb.kicad_pcb from above]

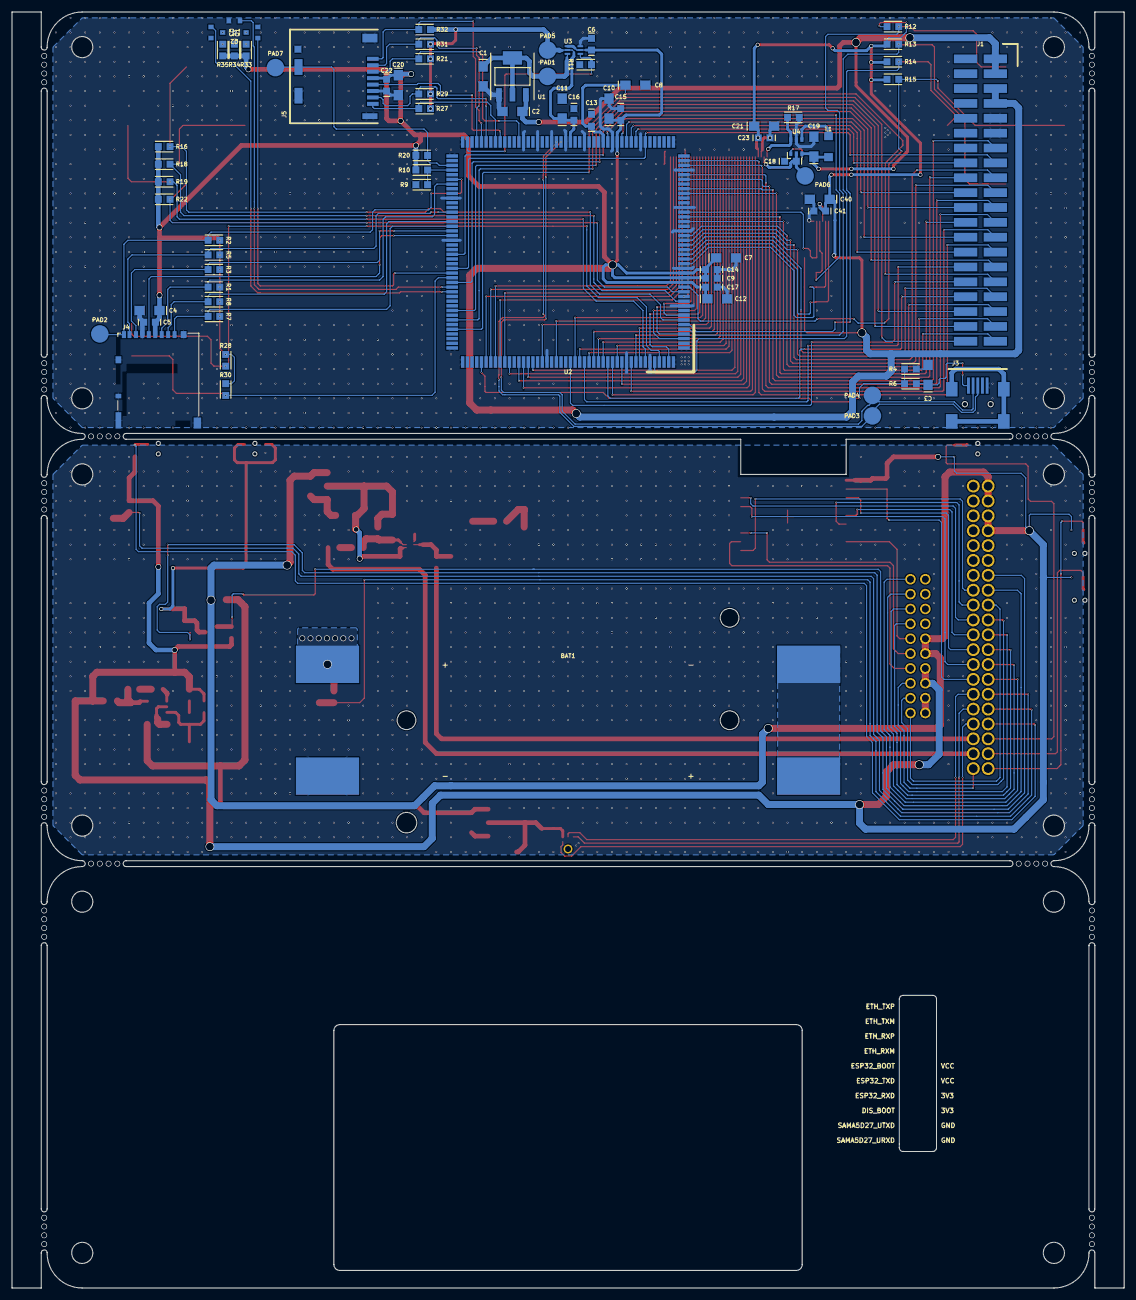
[picture p8: board a5d27_handheld_console_pcb.kicad_pcb from below]

Board: 2 copper layers, 190.0 x 218.0 mm, 153 parts (76 on the bottom side), 158 nets.

Other parts of the board:
A: A; SWITCH
B: B; SWITCH
DOWN: DOWN; SWITCH
LEFT: LEFT; SWITCH
RIGHT: RIGHT; SWITCH
UP: UP; SWITCH
X: X; SWITCH
Y: Y; SWITCH

Their connections:
/1_BOARD/BTN_1: UP.2; also elsewhere on the board
/1_BOARD/BTN_2: DOWN.2; also elsewhere on the board
/1_BOARD/BTN_3: RIGHT.2; also elsewhere on the board
/1_BOARD/BTN_4: LEFT.2; also elsewhere on the board
/1_BOARD/BTN_5: X.2; also elsewhere on the board
/1_BOARD/BTN_6: Y.2; also elsewhere on the board
/1_BOARD/BTN_7: A.2; also elsewhere on the board
/1_BOARD/BTN_8: B.2; also elsewhere on the board
GND_1: A.3, A.4, B.3, B.4, DOWN.3, DOWN.4, LEFT.3, LEFT.4, RIGHT.3, RIGHT.4, UP.3, UP.4, X.3, X.4, Y.3, Y.4; also elsewhere on the board
